harukakido/LaserBasedWirelessPowerTransmission/Appendix 1.pdf

# EE480 Senior Design I Laser-Based Wireless Power Transmission Initial Circuit/Code Design Review

# Appendix 1: Experimental Thermoelectric Plate: PCB Circuit Schematics

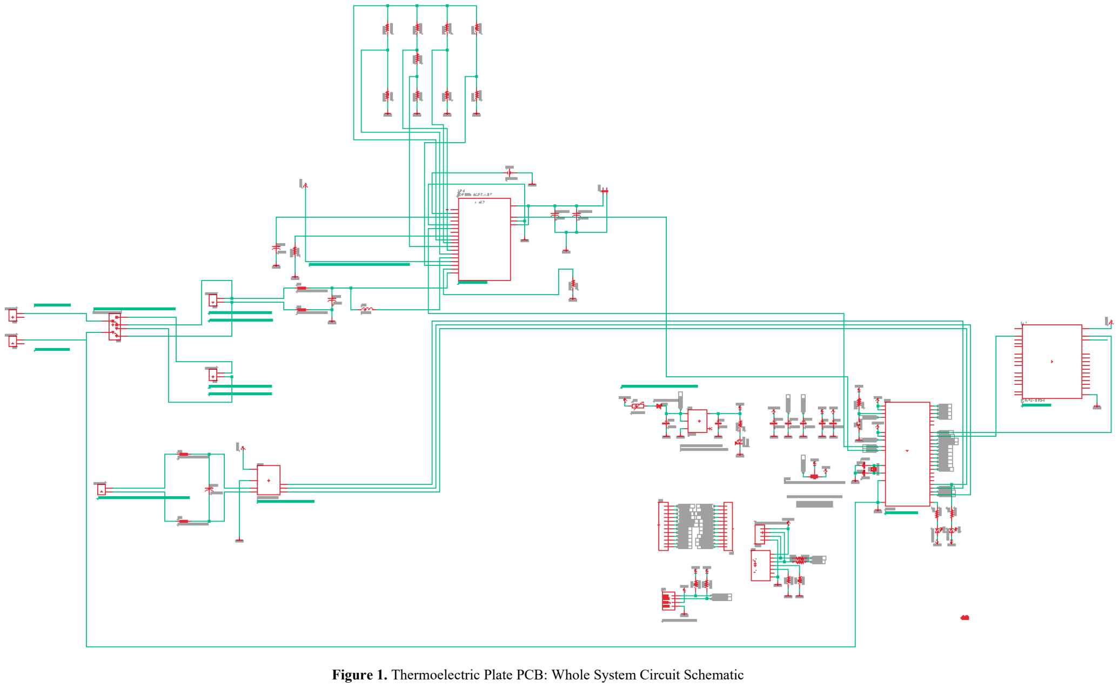
[picture p20: page 2]

Figure 1. Thermoelectric Plate PCB: Whole System Circuit Schematic

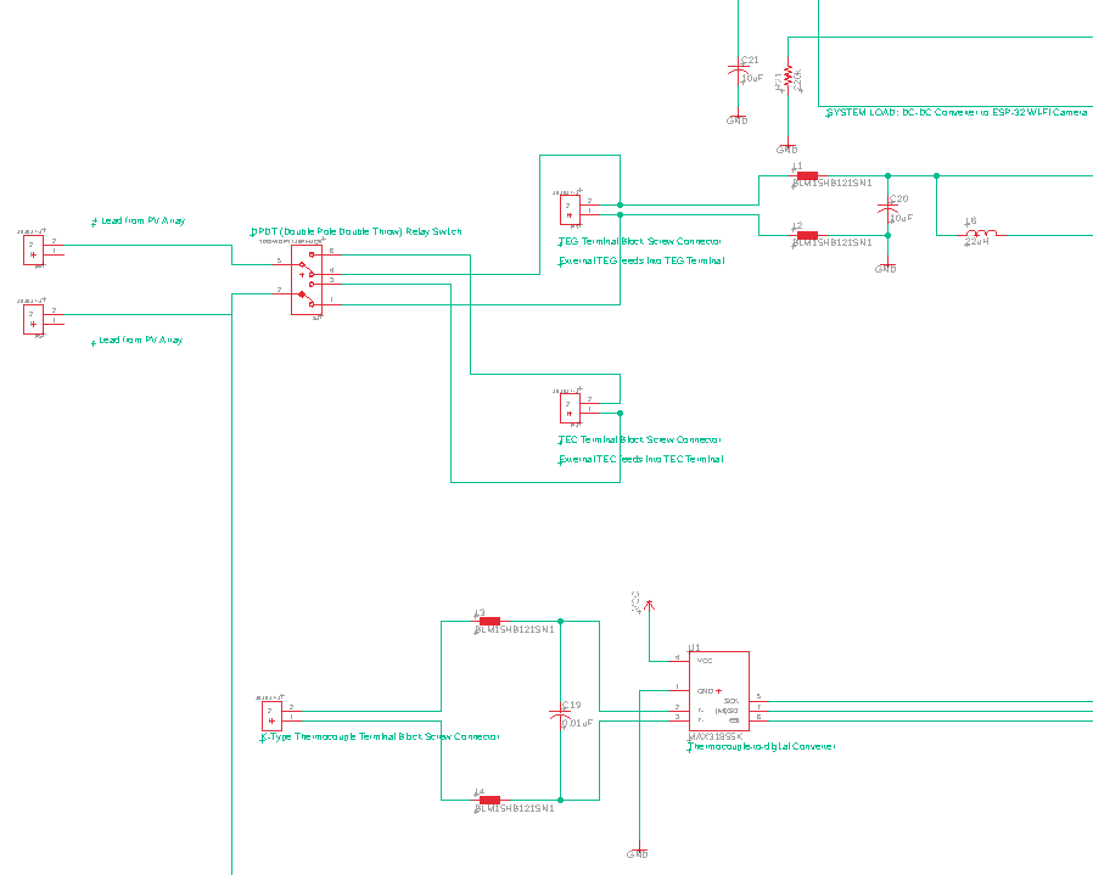
[picture p21: figure]

Figure 2. Thermoelectric Plate PCB: Circuit Schematic, Zoomed in 1: Dual Function TEG/TEC Switching Unit and Thermocouple to Digital Converter

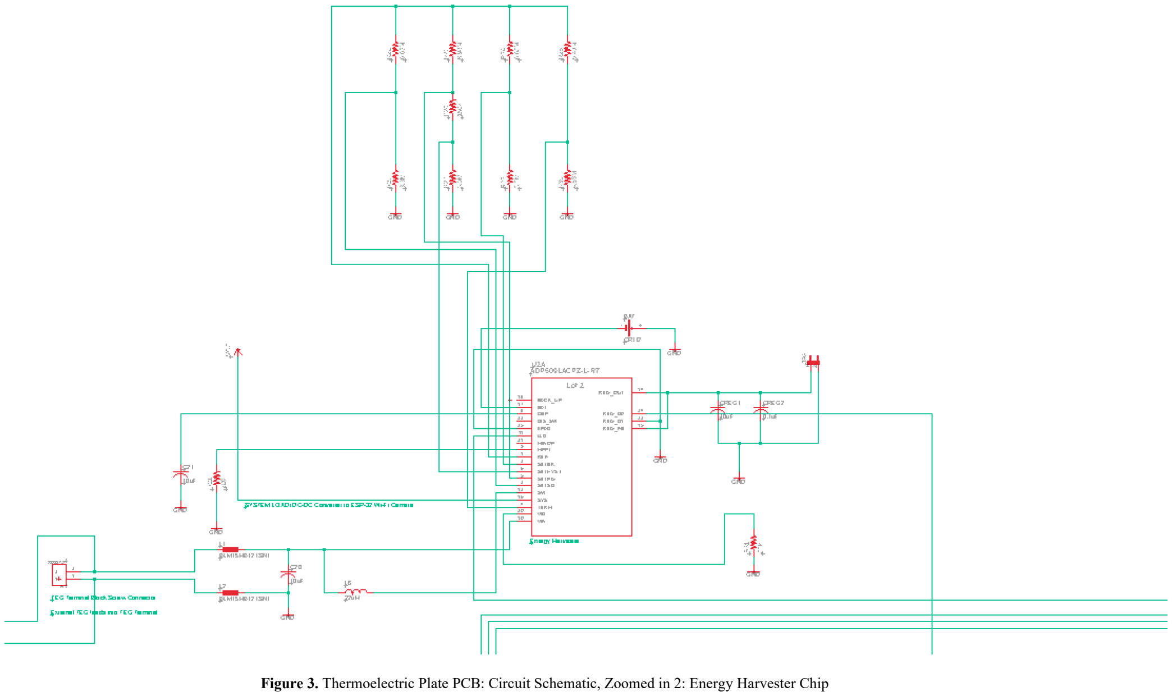
[picture p22: page 4]

Figure 3. Thermoelectric Plate PCB: Circuit Schematic, Zoomed in 2: Energy Harvester Chip

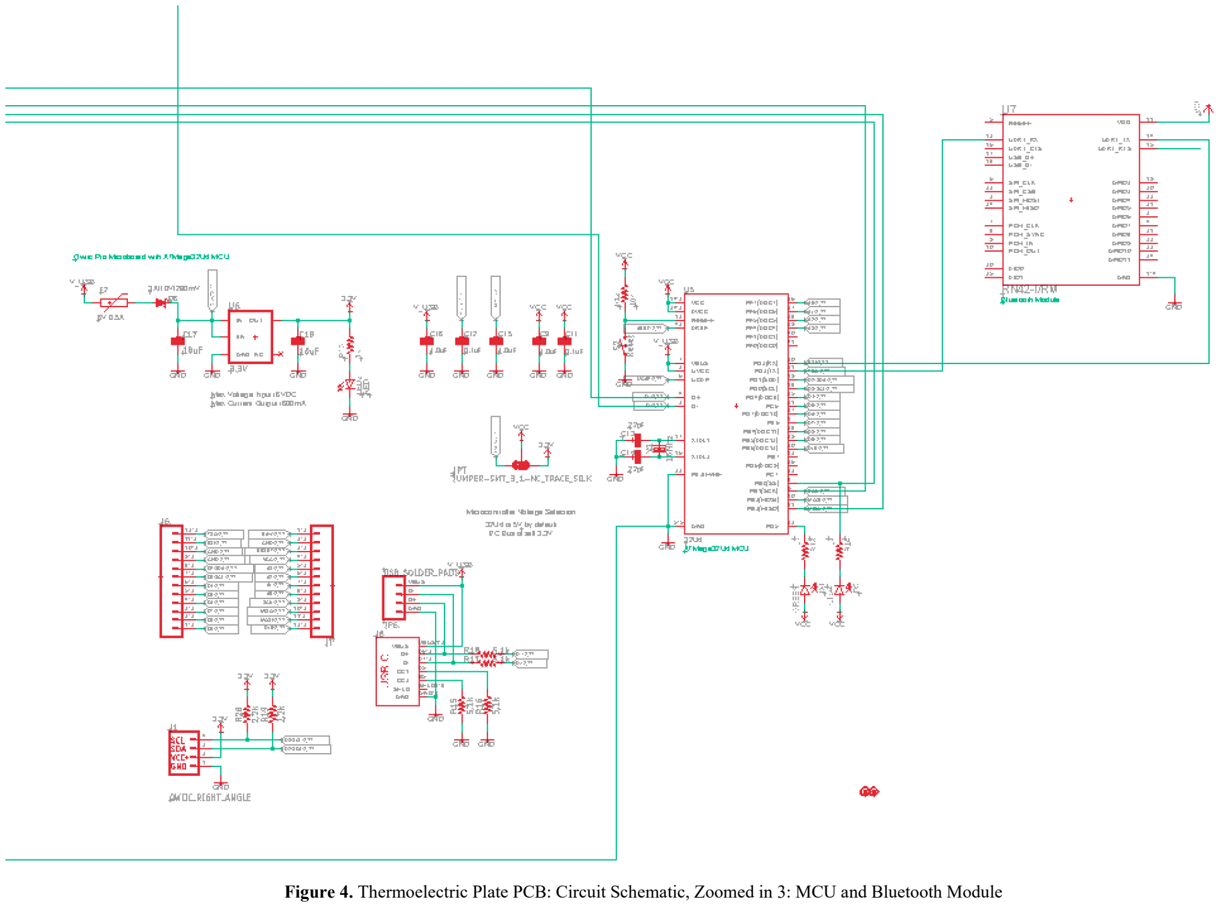
[picture p23: page 5]

Figure 4. Thermoelectric Plate PCB: Circuit Schematic, Zoomed in 3: MCU and Bluetooth Module
