harukakido/LaserBasedWirelessPowerTransmission/Experimental Thermoelectric Plate. PCB Circuit Schematics.pdf

# EE480 Senior Design I Laser-Based Wireless Power Transmission Initial Circuit/Code Design Review

# Appendix 1: Experimental Thermoelectric Plate: PCB Circuit Schematics

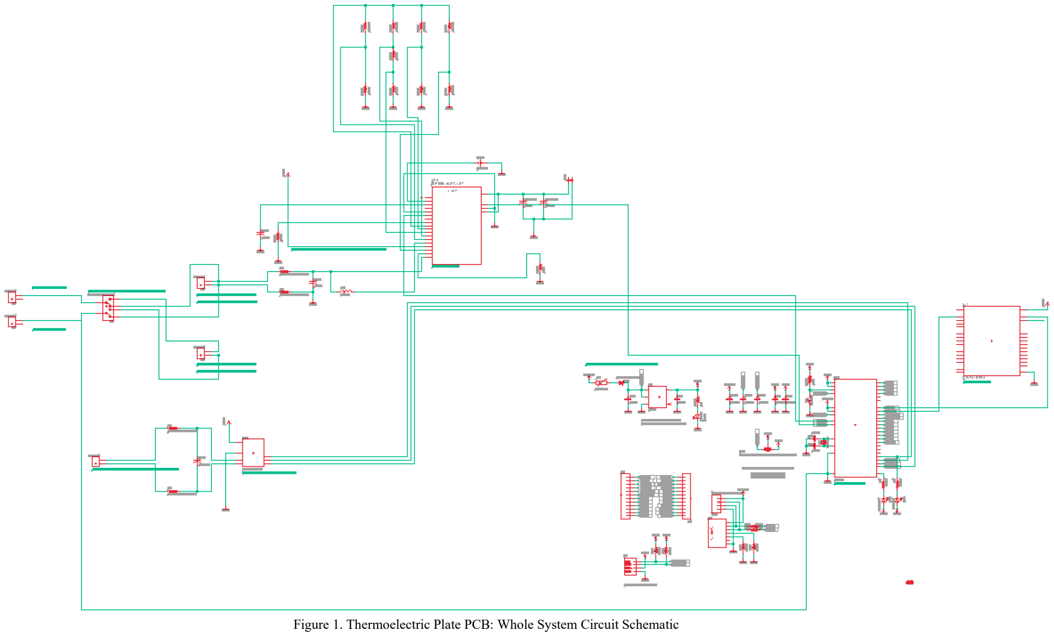
[picture p24: page 2]

Figure 1. Thermoelectric Plate PCB: Whole System Circuit Schematic


Figure 2. Thermoelectric Plate PCB: Circuit Schematic, Zoomed in 1

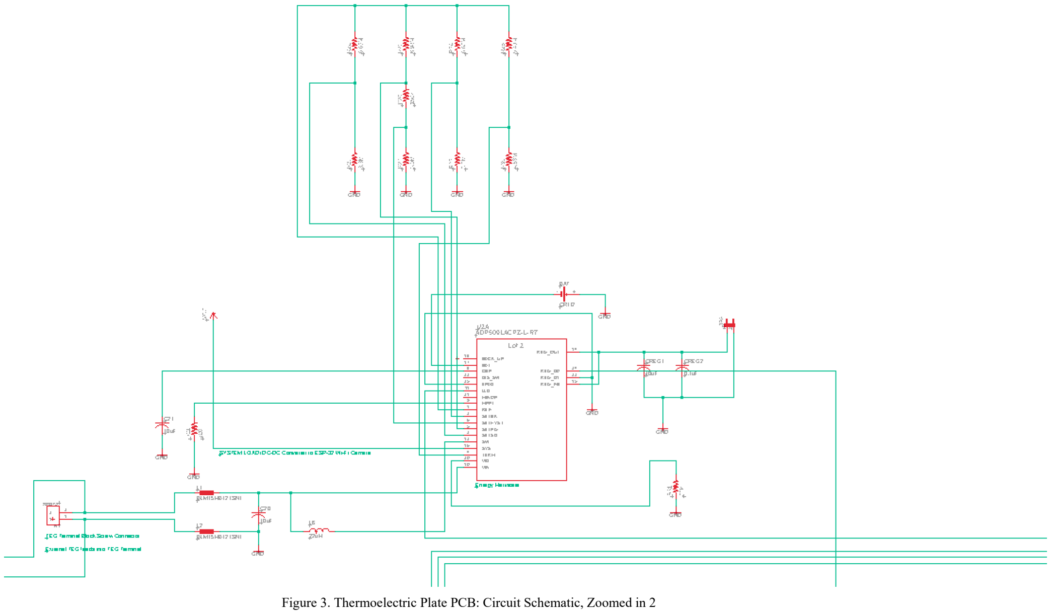
[picture p25: page 4]

Figure 3. Thermoelectric Plate PCB: Circuit Schematic, Zoomed in 2

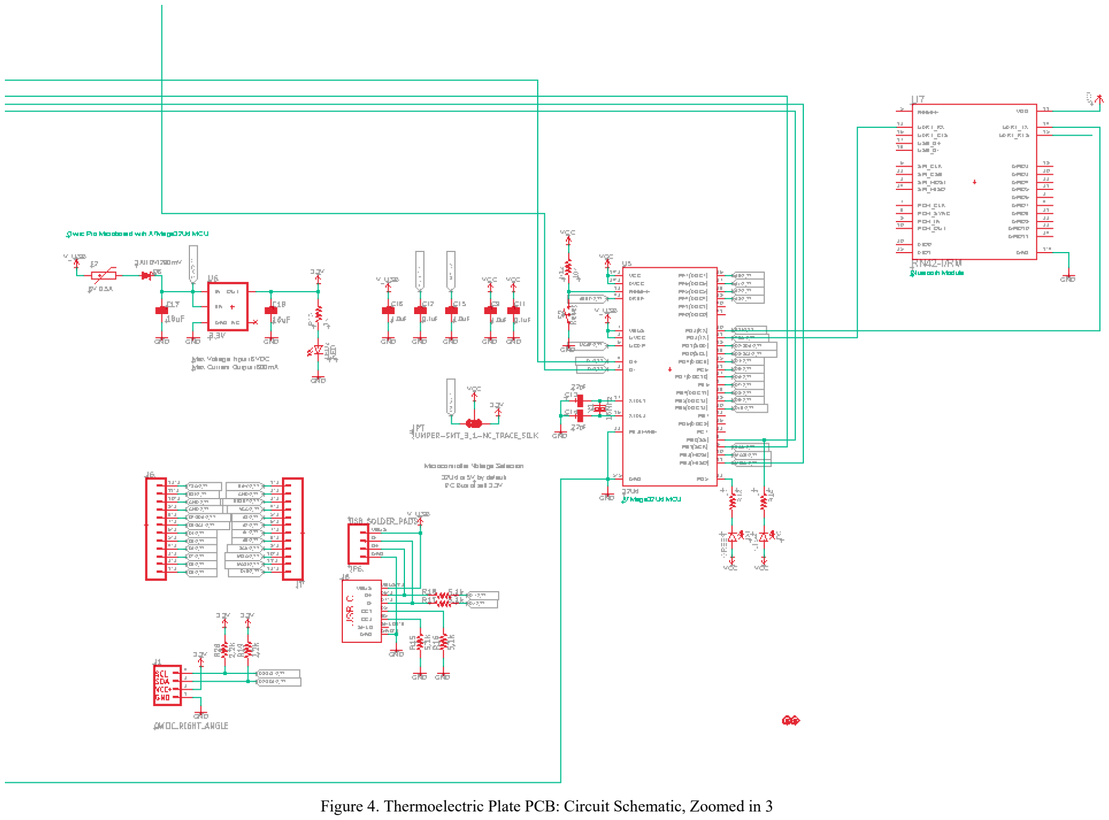
[picture p26: page 5]

Figure 4. Thermoelectric Plate PCB: Circuit Schematic, Zoomed in 3
