harukakido/LaserBasedWirelessPowerTransmission/TEG-TEC Thermal Sensing and Regulating Board.sch

## EAGLE design TEG-TEC Thermal Sensing and Regulating Board.sch (2022-11-13)

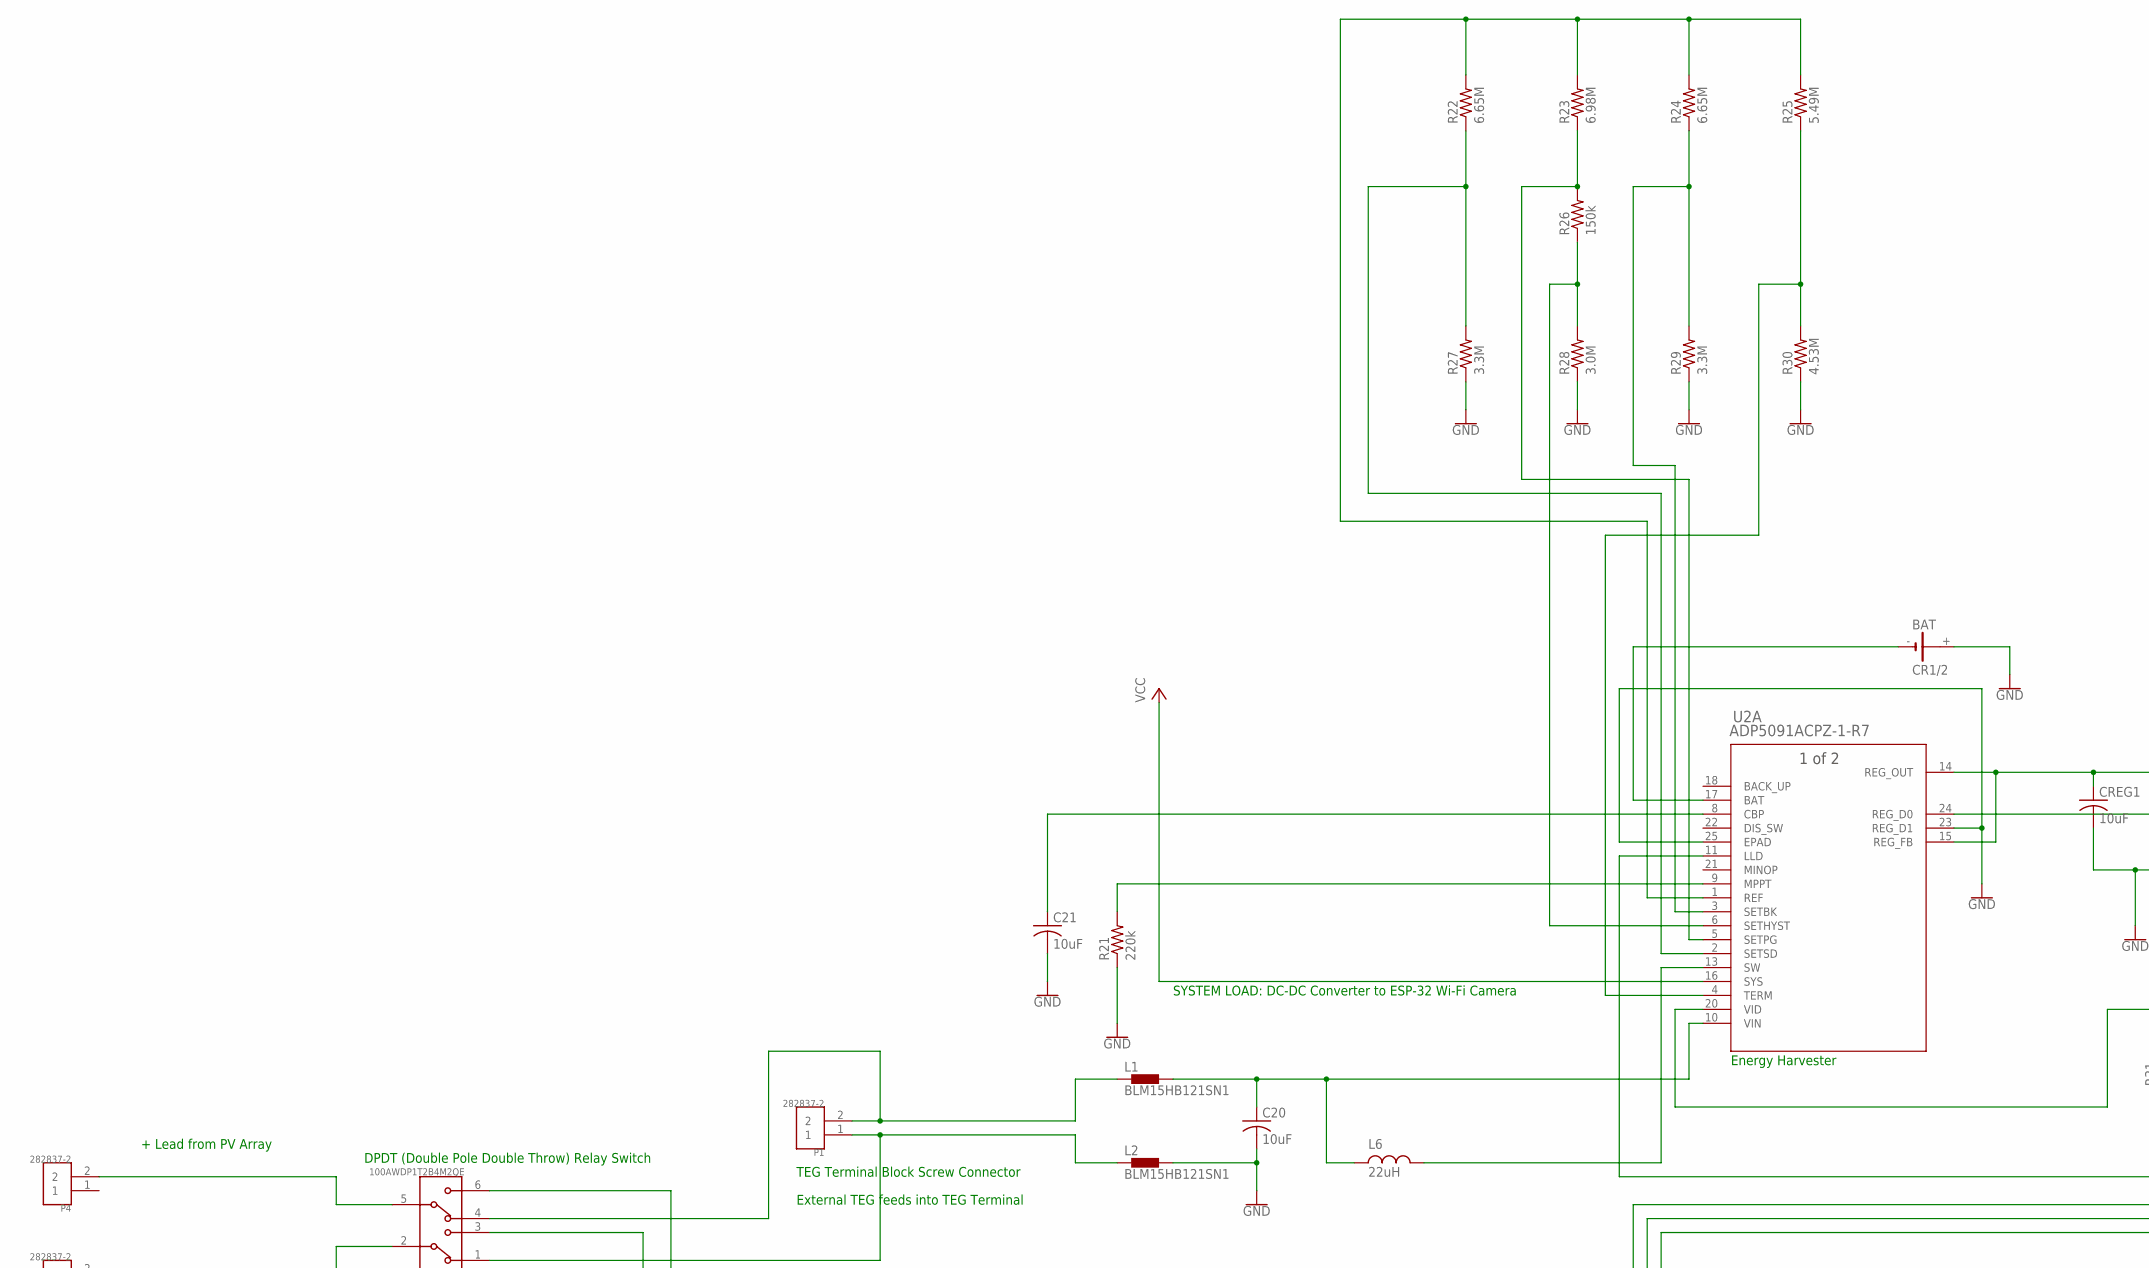
[picture p27: schematic TEG-TEC Thermal Sensing and Regulating Board.sch, sheet 1, part in row 1, column 1]

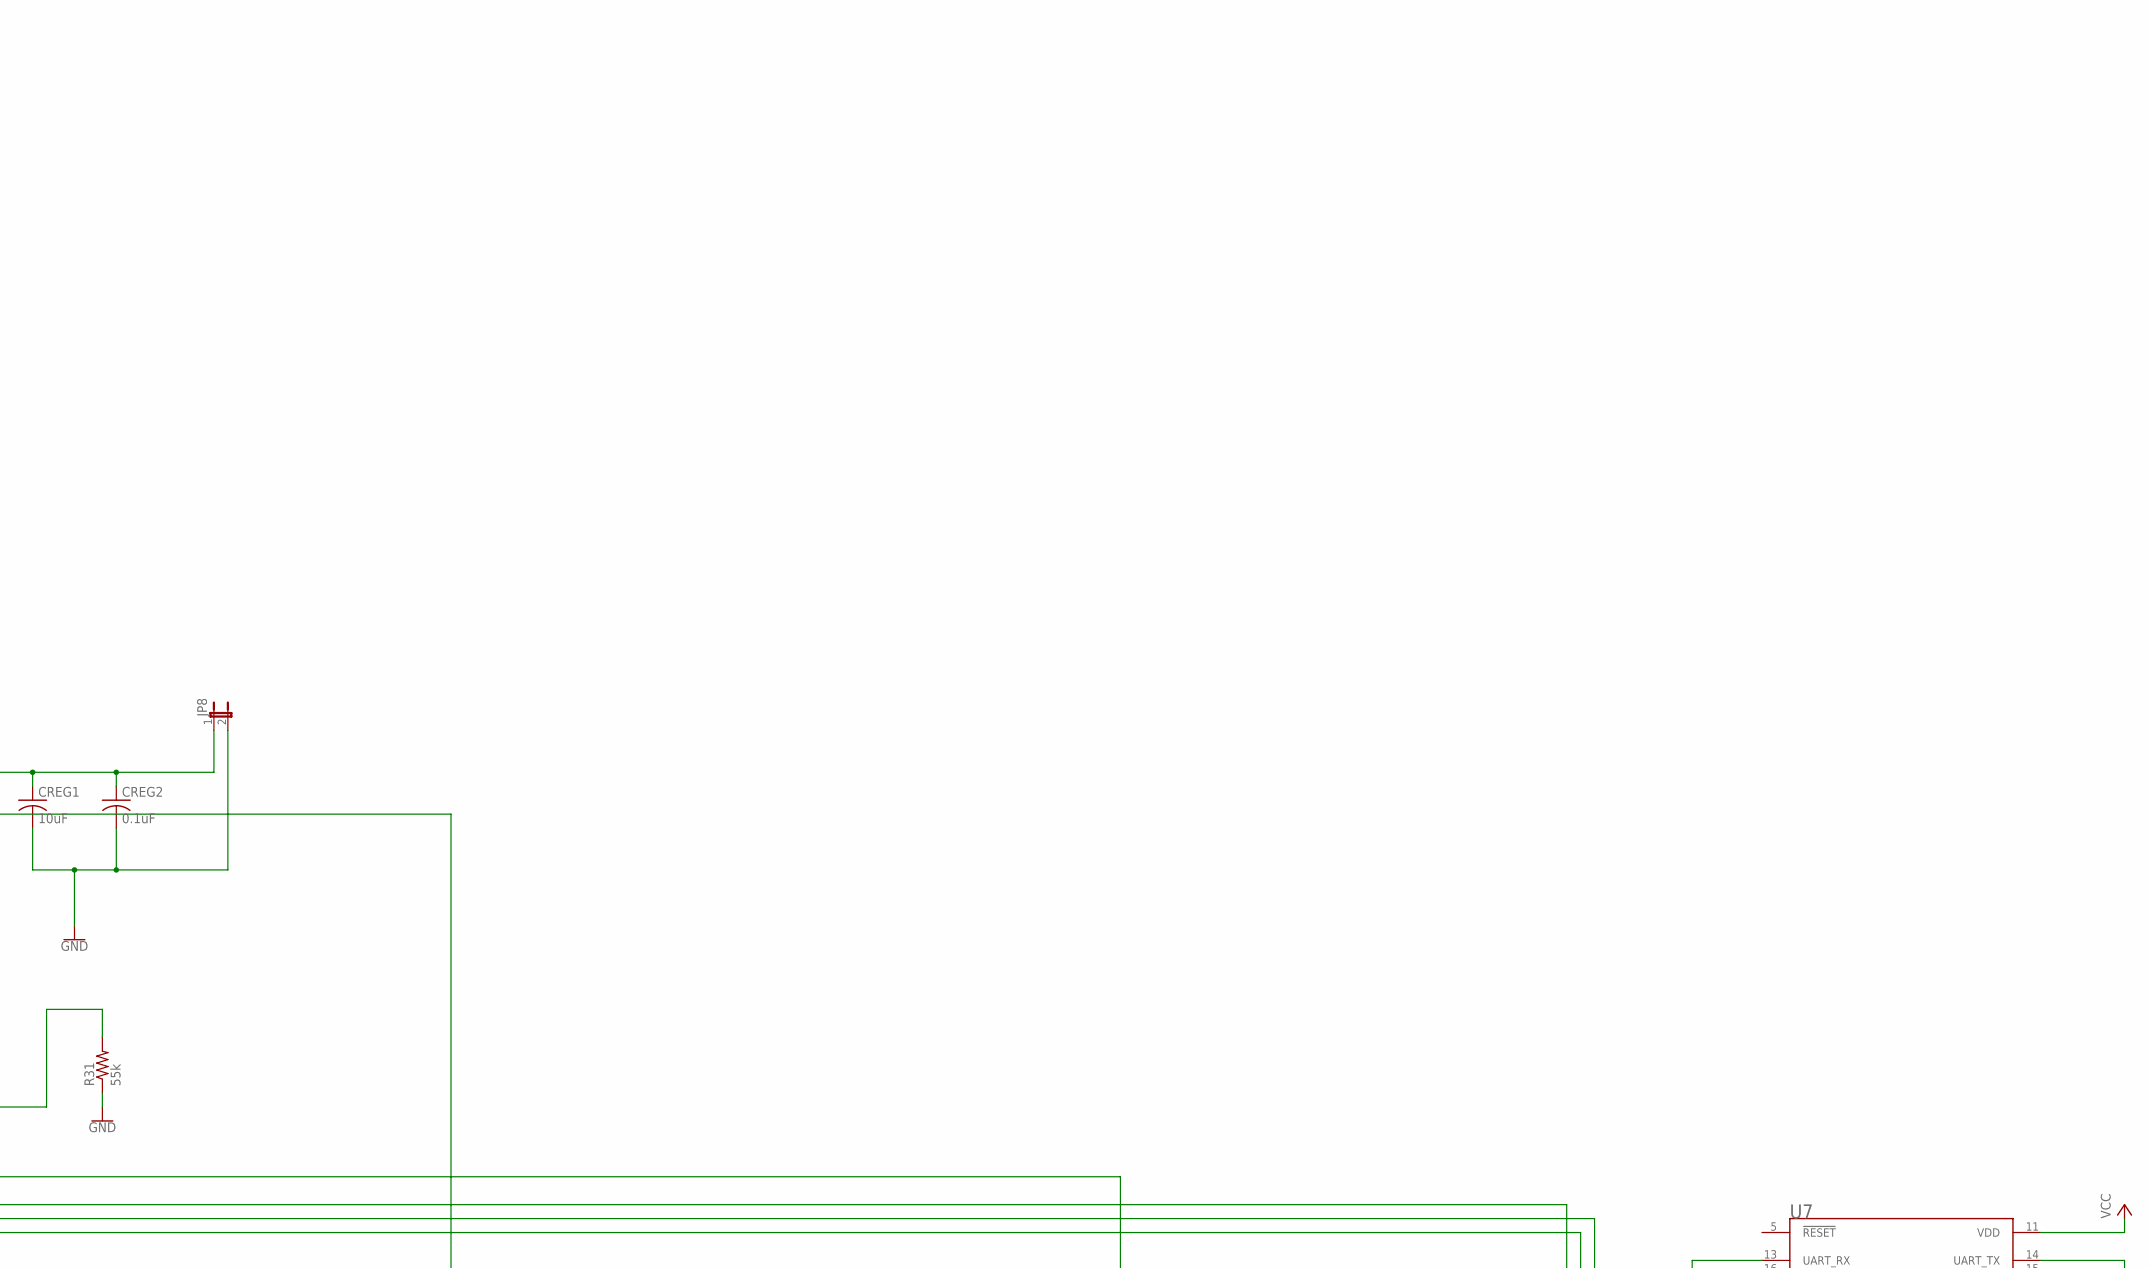
[picture p28: schematic TEG-TEC Thermal Sensing and Regulating Board.sch, sheet 1, part in row 1, column 2]

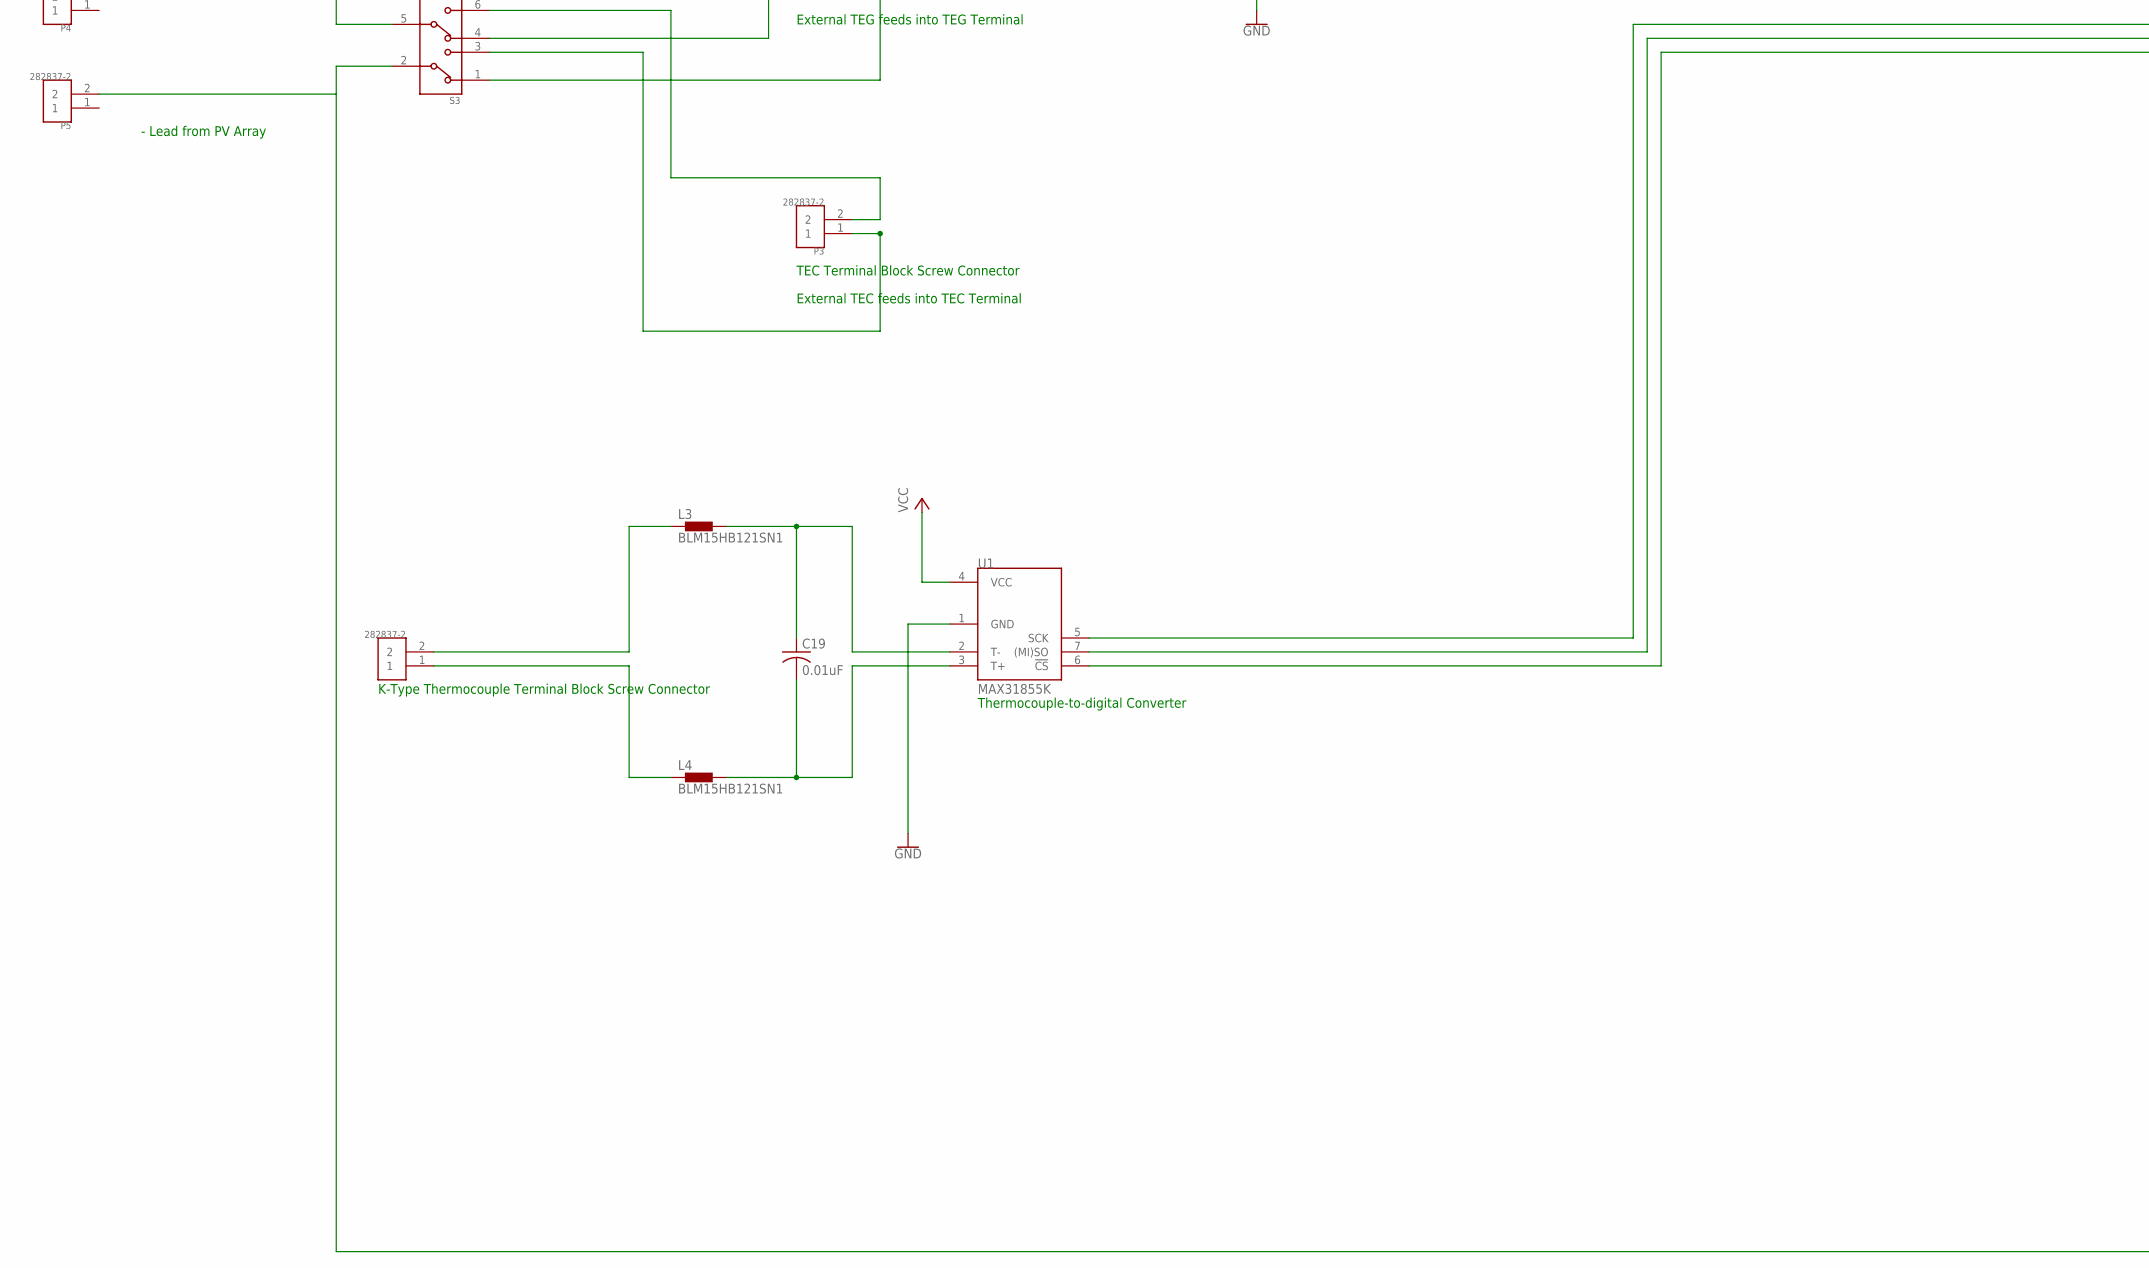
[picture p29: schematic TEG-TEC Thermal Sensing and Regulating Board.sch, sheet 1, part in row 2, column 1]

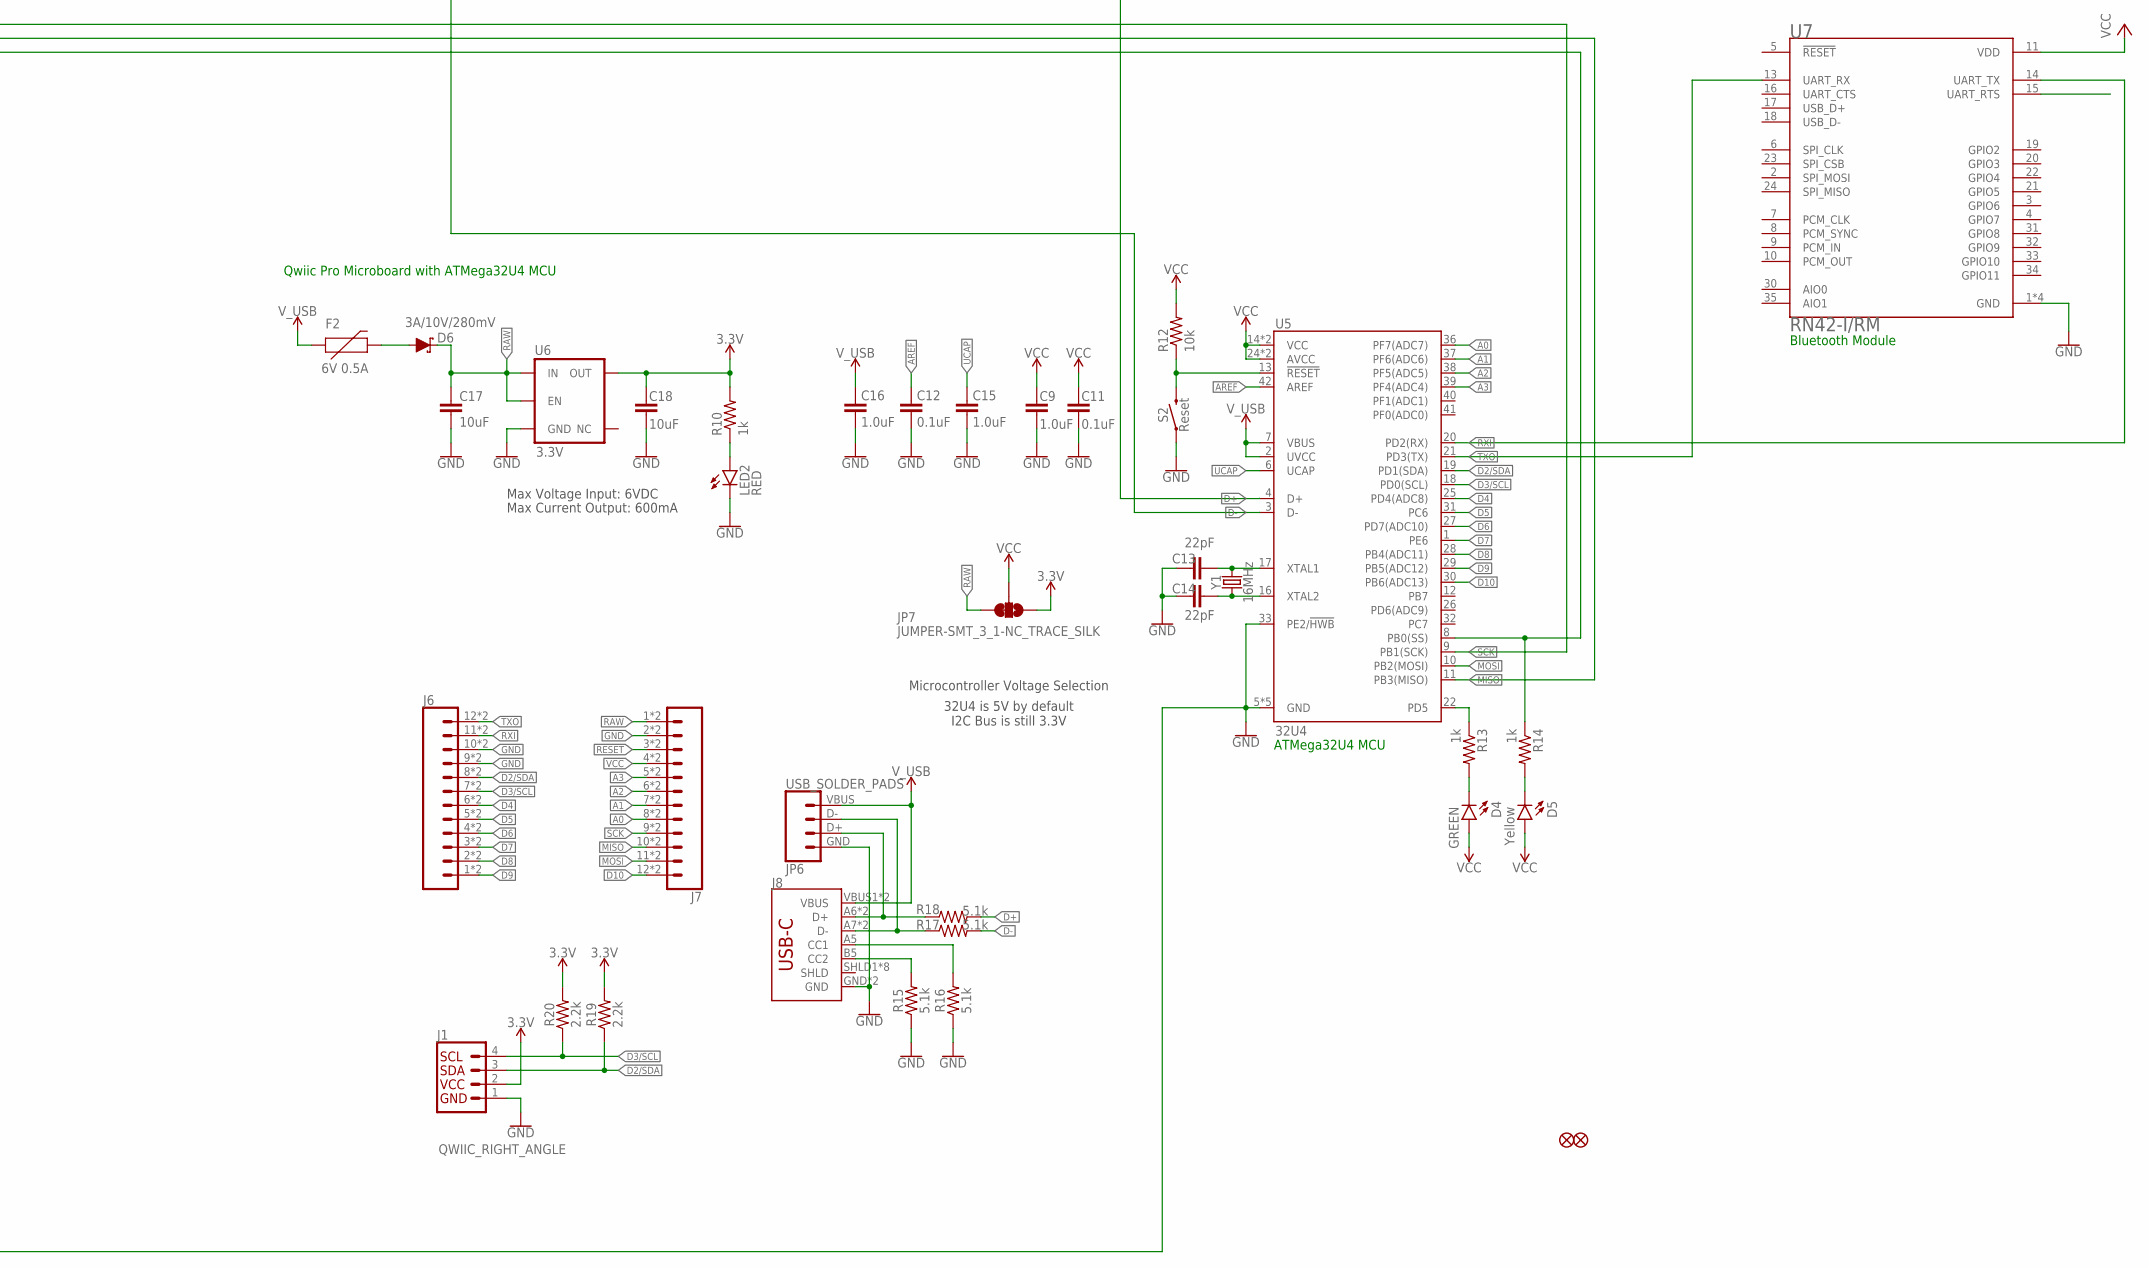
[picture p30: schematic TEG-TEC Thermal Sensing and Regulating Board.sch, sheet 1, part in row 2, column 2]

Parts:
BAT: CR1/2
C9, C15, C16: 1.0uF; 0402-TIGHT
C11, C12: 0.1uF; 0402-TIGHT
C13, C14: 22pF; 0402-TIGHT
C17, C18: 10uF; 0603
C19: 0.01uF; C025-024X044
C20, C21: 10uF; C025-024X044
CREG1: 10uF; C025-024X044
CREG2: 0.1uF; C025-024X044
D4: GREEN; LED-0603
D5: Yellow; LED-0603
D6: 3A/10V/280mV; SOD-323
F2: 6V 0.5A; 0805
J1: QWIIC_RIGHT_ANGLE; JST04_1MM_RA
J6, J7: CONN_12CASTLE; 1X12_CASTELLATED
J8: USB_C5; USB-C-16P-5
JP3, JP5: FIDUCIAL1X2; FIDUCIAL-1X2
JP6: USB_SOLDER_PADS; USB-SOLDER-PADS
JP7: JUMPER-SMT_3_1-NC_TRACE_SILK; SMT-JUMPER_3_1-NC_TRACE_SILK
JP8: JP1E; JP1
L1, L2, L3, L4: BLM15HB121SN1; 0402
LED2: RED; LED-0603
P1, P2, P3, P4, P5: 282837-2; TE_282837-2
R10, R13, R14: 1k; 0402-TIGHT
R12: 10k; 0402-TIGHT
R15, R16, R17, R18: 5.1k; 0402-TIGHT
R19, R20: 2.2k; 0402-TIGHT
R21: 220k; 0204V
R22, R24: 6.65M; 0204V
R23: 6.98M; 0204V
R25: 5.49M; 0204V
R26: 150k; 0204V
R27, R29: 3.3M; 0204V
R28: 3.0M; 0204V
R30: 4.53M; 0204V
R31: 55k; 0204V
S2: Reset; TACTILE_SWITCH_SMD_4.6X2.8MM
S3: 100AWDP1T2B4M2QE; SW_100AWDP1T2B4M2QE
U1: MAX31855K; SO08
U2: ADP5091ACPZ-1-R7; ADP5091ACPZ-1-R7_ADI
U5: 32U4; QFN-44-NOPAD_1:1-LESS_PASTE
U6: 3.3V; SOT23-5
U7: RN42-I/RM; XCVR_RN42-I/RM
Y1: 16MHz; CRYSTAL-SMD-2.0X1.6MM

Connections:
3.3V: C18.2, J1.2, JP7.1, R10.2, R19.2, R20.2, U6.5 (OUT)
A0: J7.8, U5.36 (PF7(ADC7))
A1: J7.7, U5.37 (PF6(ADC6))
A2: J7.6, U5.38 (PF5(ADC5))
A3: J7.5, U5.39 (PF4(ADC4))
AREF: C12.2, U5.42 (AREF)
D2/SDA: J1.3, J6.8, R19.1, U5.19 (PD1(SDA))
D3/SCL: J1.4, J6.7, R20.1, U5.18 (PD0(SCL))
D4: J6.6, U5.25 (PD4(ADC8))
D5: J6.5, U5.31 (PC6)
D6: J6.4, U5.27 (PD7(ADC10))
D7: J6.3, U5.1 (PE6)
D8: J6.2, U5.28 (PB4(ADC11))
D9: J6.1, U5.29 (PB5(ADC12))
D10: J7.12, U5.30 (PB6(ADC13))
D+: R18.2, U2.11 (LLD), U5.4 (D+)
D-: R17.2, U2.24 (REG_D0), U5.3 (D-)
D-_HV1: J8.A7 (D-), JP6.D- (2), R17.1
DP_HV1: J8.A6 (D+), JP6.D+ (3), R18.1
GND: BAT.+, C9.1, C11.1, C12.1, C13.2, C14.2, C15.1, C16.1, C17.1, C18.1, C20.2, C21.2, CREG1.2, CREG2.2, J1.1, J6.9, J6.10, J7.2, J8.GND, JP6.GND (4), JP8.2, L2.2, LED2.C, P5.2, R15.1, R16.1, R21.1, R27.1, R28.1, R29.1, R30.1, R31.1, S2.1, S3.2, U1.1 (GND), U5.5 (GND), U5.33 (PE2/!HWB), U6.2 (GND), U7.1 (GND)
MISO: J7.10, U1.7 ((MI)SO), U5.11 (PB3(MISO))
MOSI: J7.11, U5.10 (PB2(MOSI))
unnamed: LED2.A, R10.1
unnamed: C14.1, U5.16 (XTAL2), Y1.1
unnamed: C13.1, U5.17 (XTAL1), Y1.3 (2)
unnamed: D5.C, R14.2
unnamed: D4.C, R13.2
unnamed: J8.A5 (CC1), R16.2
unnamed: J8.B5 (CC2), R15.2
unnamed: P3.2, S3.6
unnamed: L1.1, P1.2, S3.4
unnamed: L2.1, P1.1, S3.1
unnamed: P3.1, S3.3
unnamed: L3.1, P2.2
unnamed: L4.1, P2.1
unnamed: C19.1, L3.2, U1.2 (T-)
unnamed: C19.2, L4.2, U1.3 (T+)
unnamed: C20.1, L1.2, U2.10 (VIN)
unnamed: R21.2, U2.9 (MPPT)
unnamed: C21.1, U2.8 (CBP)
unnamed: R22.2, R23.2, R24.2, R25.2, U2.1 (REF)
unnamed: R22.1, R27.2, U2.2 (SETSD)
unnamed: R23.1, R26.2, U2.5 (SETPG)
unnamed: R26.1, R28.2, U2.6 (SETHYST)
unnamed: R24.1, R29.2, U2.3 (SETBK)
unnamed: R25.1, R30.2, U2.4 (TERM)
unnamed: CREG1.1, CREG2.1, JP8.1, U2.14 (REG_OUT), U2.15 (REG_FB)
unnamed: BAT.-, U2.17 (BAT)
unnamed: R31.2, U2.20 (VID)
unnamed: U2.23 (REG_D1), U2.25 (EPAD)
unnamed: P4.2, S3.5
RAW: C17.2, D6.C, J7.1, JP7.3, U6.1 (IN), U6.3 (EN)
RESET: J7.3, R12.1, S2.3 (2), U5.13 (!RESET)
RXI: J6.11, U5.20 (PD2(RX)), U7.14 (UART_TX)
RXLED1: R14.1, U1.6 (!CS), U5.8 (PB0(SS))
SCK: J7.9, U1.5 (SCK), U5.9 (PB1(SCK))
TXLED1: R13.1, U5.22 (PD5)
TXO: J6.12, U5.21 (PD3(TX)), U7.13 (UART_RX)
UCAP: C15.2, U5.6 (UCAP)
USB_RAW1: D6.A, F2.2
VCC: C9.2, C11.2, D4.A, D5.A, J7.4, JP7.2, R12.2, U1.4 (VCC), U2.16 (SYS), U5.14 (VCC), U5.24 (AVCC), U7.11 (VDD)
V_USB: C16.2, F2.1, J8.VBUS1 (VBUS), JP6.VBUS (1), U5.2 (UVCC), U5.7 (VBUS)

Notes on the sheet:
Max Voltage Input: 6VDC
Max Current Output: 600mA
Microcontroller Voltage Selection
32U4 is 5V by default I2C Bus is still 3.3V
Bluetooth Module
Thermocouple-to-digital Converter
Energy Harvester
Qwiic Pro Microboard with ATMega32U4 MCU
ATMega32U4 MCU
TEC Terminal Block Screw Connector
DPDT (Double Pole Double Throw) Relay Switch
External TEC feeds into TEC Terminal
SYSTEM LOAD: DC-DC Converter to ESP-32 Wi-Fi Camera
- Lead from PV Array
+ Lead from PV Array
TEG Terminal Block Screw Connector
External TEG feeds into TEG Terminal
K-Type Thermocouple Terminal Block Screw Connector

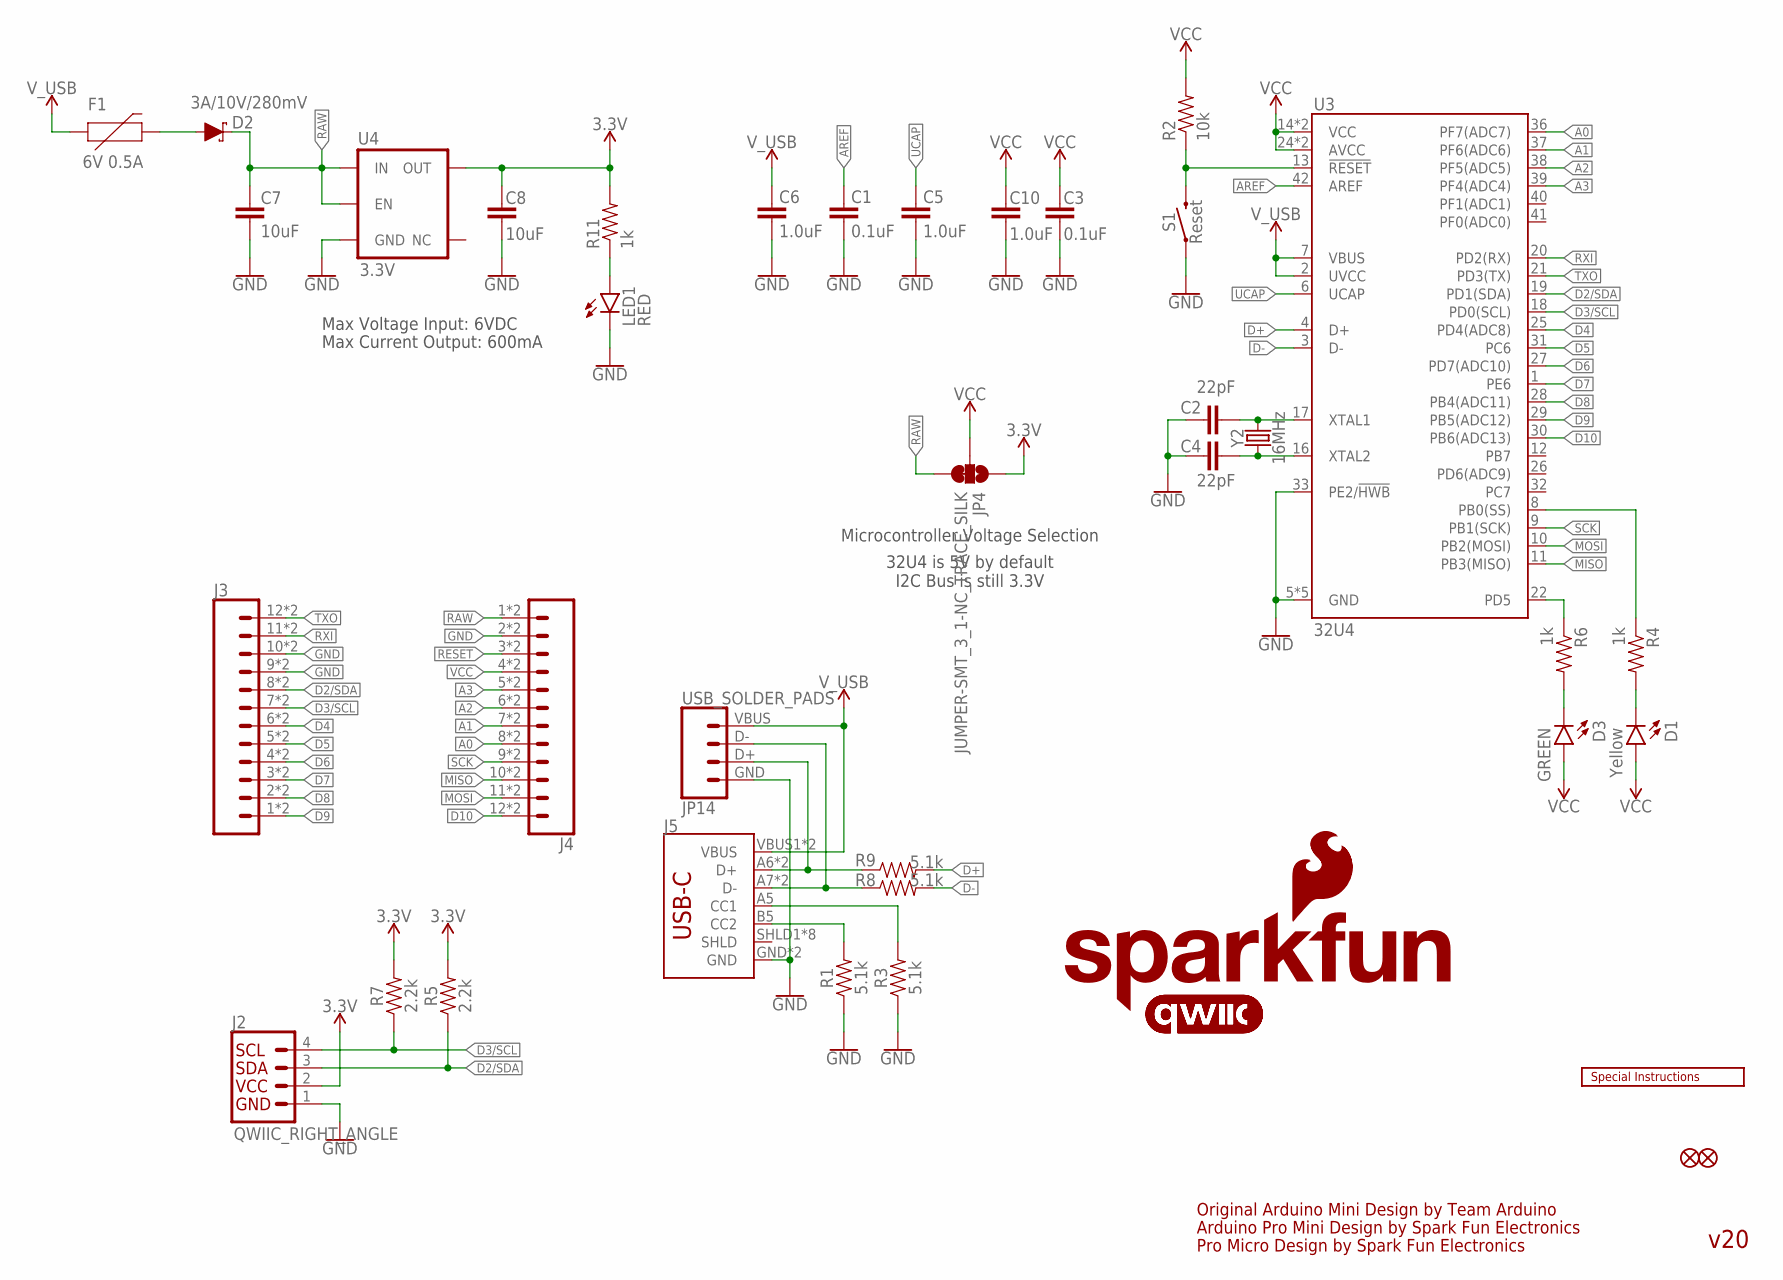
[picture p31: schematic TEG-TEC Thermal Sensing and Regulating Board.sch, sheet 2]

Parts:
C1, C3: 0.1uF; 0402-TIGHT
C2, C4: 22pF; 0402-TIGHT
C5, C6, C10: 1.0uF; 0402-TIGHT
C7, C8: 10uF; 0603
D1: Yellow; LED-0603
D2: 3A/10V/280mV; SOD-323
D3: GREEN; LED-0603
F1: 6V 0.5A; 0805
J2: QWIIC_RIGHT_ANGLE; JST04_1MM_RA
J3, J4: CONN_12CASTLE; 1X12_CASTELLATED
J5: USB_C5; USB-C-16P-5
JP1, JP2: FIDUCIAL1X2; FIDUCIAL-1X2
JP4: JUMPER-SMT_3_1-NC_TRACE_SILK; SMT-JUMPER_3_1-NC_TRACE_SILK
JP14: USB_SOLDER_PADS; USB-SOLDER-PADS
LED1: RED; LED-0603
LOGO1: SFE_LOGO_NAME_FLAME.1_INCH; SFE_LOGO_NAME_FLAME_.1
LOGO2: QWIIC_LOGO_4MM; QWIIC_4MM
LOGO3: QWIIC_LOGO_6MM; QWIIC_6MM
LOGO4: SFE_LOGO_FLAME.1_INCH; SFE_LOGO_FLAME_.1
LOGO5: SPECIAL_INSTRUCTIONS-ORDERING; ORDERING_INSTRUCTIONS
R1, R3, R8, R9: 5.1k; 0402-TIGHT
R2: 10k; 0402-TIGHT
R4, R6, R11: 1k; 0402-TIGHT
R5, R7: 2.2k; 0402-TIGHT
S1: Reset; TACTILE_SWITCH_SMD_4.6X2.8MM
U3: 32U4; QFN-44-NOPAD_1:1-LESS_PASTE
U4: 3.3V; SOT23-5
Y2: 16MHz; CRYSTAL-SMD-2.0X1.6MM

Connections:
3.3V: C8.2, J2.2, JP4.1, R5.2, R7.2, R11.2, U4.5 (OUT)
A0: J4.8, U3.36 (PF7(ADC7))
A1: J4.7, U3.37 (PF6(ADC6))
A2: J4.6, U3.38 (PF5(ADC5))
A3: J4.5, U3.39 (PF4(ADC4))
AREF: C1.2, U3.42 (AREF)
D2/SDA: J2.3, J3.8, R5.1, U3.19 (PD1(SDA))
D3/SCL: J2.4, J3.7, R7.1, U3.18 (PD0(SCL))
D4: J3.6, U3.25 (PD4(ADC8))
D5: J3.5, U3.31 (PC6)
D6: J3.4, U3.27 (PD7(ADC10))
D7: J3.3, U3.1 (PE6)
D8: J3.2, U3.28 (PB4(ADC11))
D9: J3.1, U3.29 (PB5(ADC12))
D10: J4.12, U3.30 (PB6(ADC13))
D+: R9.2, U3.4 (D+)
D-: R8.2, U3.3 (D-)
D-_HV: J5.A7 (D-), JP14.D- (2), R8.1
DP_HV: J5.A6 (D+), JP14.D+ (3), R9.1
GND: C1.1, C2.2, C3.1, C4.2, C5.1, C6.1, C7.1, C8.1, C10.1, J2.1, J3.9, J3.10, J4.2, J5.GND, JP14.GND (4), LED1.C, R1.1, R3.1, S1.1, U3.5 (GND), U3.33 (PE2/!HWB), U4.2 (GND)
MISO: J4.10, U3.11 (PB3(MISO))
MOSI: J4.11, U3.10 (PB2(MOSI))
unnamed: C4.1, U3.16 (XTAL2), Y2.1
unnamed: C2.1, U3.17 (XTAL1), Y2.3 (2)
unnamed: D1.C, R4.2
unnamed: D3.C, R6.2
unnamed: J5.A5 (CC1), R3.2
unnamed: J5.B5 (CC2), R1.2
unnamed: LED1.A, R11.1
RAW: C7.2, D2.C, J4.1, JP4.3, U4.1 (IN), U4.3 (EN)
RESET: J4.3, R2.1, S1.3 (2), U3.13 (!RESET)
RXI: J3.11, U3.20 (PD2(RX))
RXLED: R4.1, U3.8 (PB0(SS))
SCK: J4.9, U3.9 (PB1(SCK))
TXLED: R6.1, U3.22 (PD5)
TXO: J3.12, U3.21 (PD3(TX))
UCAP: C5.2, U3.6 (UCAP)
USB_RAW: D2.A, F1.2
VCC: C3.2, C10.2, D1.A, D3.A, J4.4, JP4.2, R2.2, U3.14 (VCC), U3.24 (AVCC)
V_USB: C6.2, F1.1, J5.VBUS1 (VBUS), JP14.VBUS (1), U3.2 (UVCC), U3.7 (VBUS)

Notes on the sheet:
Original Arduino Mini Design by Team Arduino
Arduino Pro Mini Design by Spark Fun Electronics
Max Voltage Input: 6VDC
Max Current Output: 600mA
Pro Micro Design by Spark Fun Electronics
Microcontroller Voltage Selection
v20
32U4 is 5V by default I2C Bus is still 3.3V
