harukakido/LaserBasedWirelessPowerTransmission/(notices)

Notices in the files:
parts and their libraries:
SparkFun-IC-Conversion: Licensing: Creative Commons ShareAlike 4.0 International - https://creativecommons.org/licenses/by-sa/4.0
ADP5091ACPZ-1-R7: COPYRIGHT: Copyright (C) 2018 Accelerated Designs. All rights reserved
